troelsdtu/mybuddyLED/3D files/Pushbutton_shell.stl

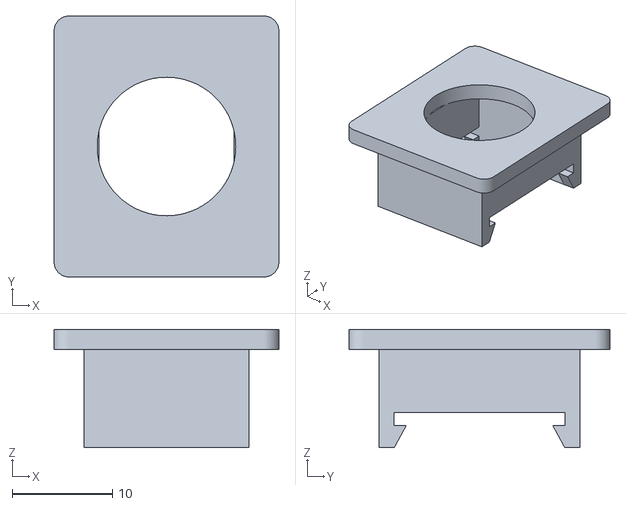
[picture p9: CAD file, 2026-10-28]
3D files/Pushbutton_shell.stl
22.4 x 26.0 x 11.8
