troelsdtu/mybuddyLED/3D files/Bottom_enclosure.stl

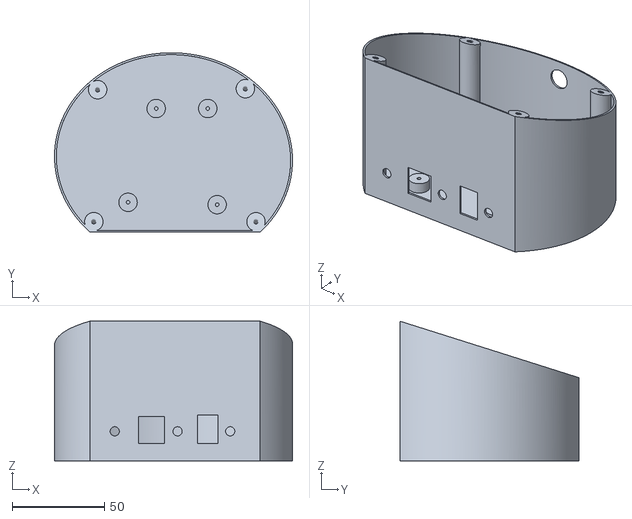
[picture p10: CAD file, 2026-10-28]
3D files/Bottom_enclosure.stl
128.9 x 97.2 x 75.7
