troelsdtu/mybuddyLED/3D files/Lid_enclosure.stl

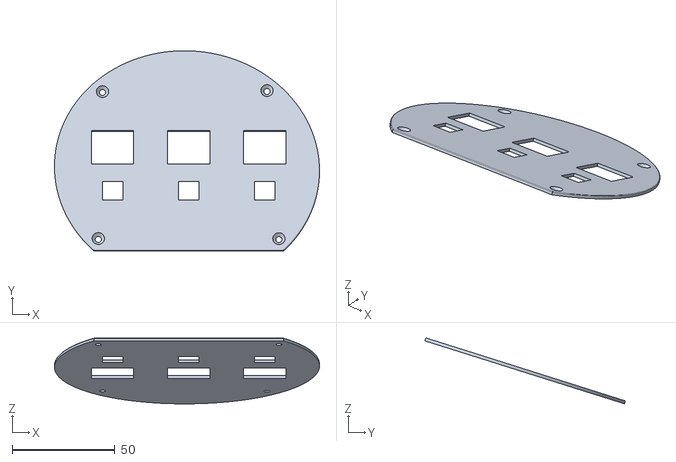
[picture p11: CAD file, 2026-10-28]
3D files/Lid_enclosure.stl
128.9 x 97.5 x 32.0
