troelsdtu/mybuddyLED/3D files/Photoresistor_shell.stl

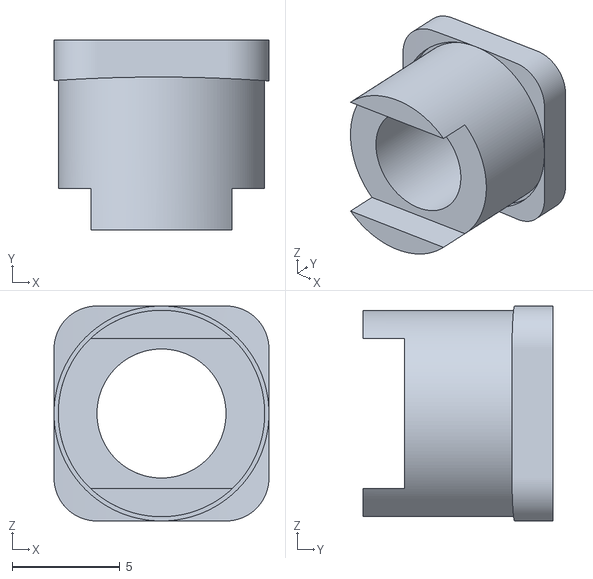
[picture p12: CAD file, 2026-10-28]
3D files/Photoresistor_shell.stl
10.00 x 8.84 x 10.0
