troelsdtu/mybuddyLED/3D files/LED_shell.stl

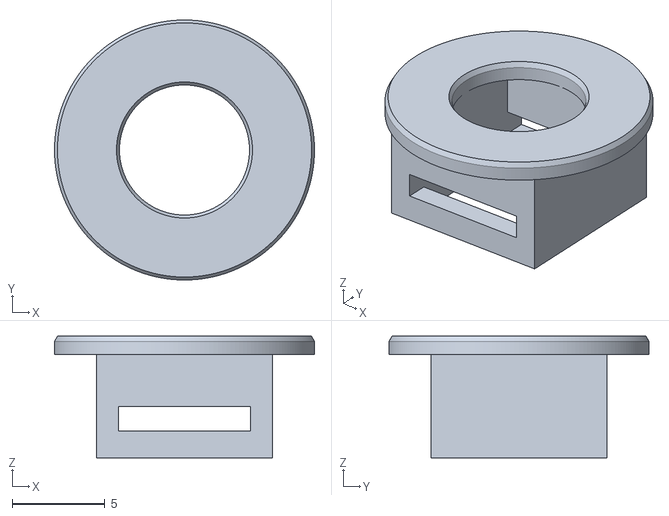
[picture p13: CAD file, 2026-10-28]
3D files/LED_shell.stl
14.0 x 14.0 x 6.55
