troelsdtu/mybuddyLED/(commit log)

2026-10-28 README version 1.0
    Added comprehensive README for MyBuddyLED project, detailing background, device specifications, electronics, parts list, and usage instructions.
2026-10-28 folder for STL files
